verus-via/AI-designed-spectrophotometer-build/git hub fidelity 1/Fidelity1/images/README.md

# Images

| File | What it is |
|---|---|
| `photo_assembled.jpg` | Photo of the finished instrument with a cuvette; cap lifted off |
| `photo_parts.jpg` | Photo of the printed parts and electronics before assembly |
| `exploded_view.png` | Annotated exploded view of the full assembly |
| `assembly_render.png` | CAD render of the assembled instrument (cuvette shown translucent) |
| `printed_parts_sheet.png` | CAD render of each printed part in print orientation |

The two renders were generated from `cad/vs_body.scad` with OpenSCAD.
