verus-via/AI-designed-spectrophotometer-build/git hub fidelity 1/Fidelity1/docs/bom.md

# Bill of materials

Prices vary by seller and are deliberately not listed.

| # | Part | Qty | Notes |
|---|---|---|---|
| 1 | ESP32-C6 SuperMini board | 1 | Board outline modelled as 25.6 × 18.0 × 1.0 mm; **measure yours**, clones differ |
| 2 | Adafruit TSL2591 breakout (original, 0.75" × 0.65") | 1 | 19.05 × 16.51 × 1.6 mm; detector plate pegs fit its two Ø2.5 mounting holes |
| 3 | WS2812B LED on a round board, ~10 mm × 3 mm | 1 | BTF-LIGHTING round WS2812B board (Amazon ASIN B01DC0J3UM) was used |
| 4 | Plano-convex half-ball lens, Ø5 mm, borosilicate (n ≈ 1.474) | 2 | Vendor-stated focal length 5 mm; flat face toward the LED / detector, convex side toward the cuvette |
| 5 | Standard macro cuvette, 12.5 × 12.5 × 45 mm, 10 mm path | 1 | Glass or polystyrene (visible only) |
| 6 | ~330 Ω resistor | 1 | In series with the LED data line |
| 7 | M2 self-tapping screws | 8 + 2 | 4 per end plate (counterbored), plus 2 up through the deck into the body |
| 8 | M3 screws | 3 | Hold the puck deck to the cup bosses (countersunk) |
| 9 | Hookup wire, 28–30 AWG | few | Silicone-insulated suits the wire channels; fits the plate grooves |
| 10 | USB-C cable | 1 | Power and serial data |
| 11 | 3D-printed parts | — | See [assembly.md](assembly.md) |

Screw lengths are not fixed by the CAD; choose lengths that bite 5–6 mm into the M2 pilots
(pilot depth 6 mm) without breaking through, and check M3 length against the 3 mm deck plus
the boss depth.
