verus-via/AI-designed-spectrophotometer-build/git hub fidelity 1/Fidelity1/stl/vs_cap.stl

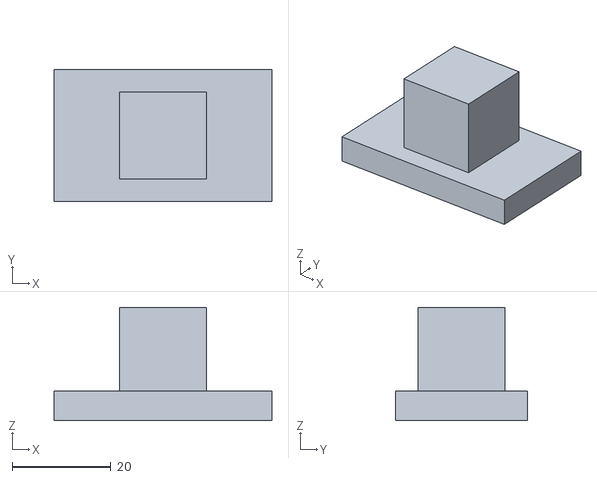
[picture p7: CAD file, 2026-10-20]
git hub fidelity 1/Fidelity1/stl/vs_cap.stl
44.2 x 26.7 x 23.0
