verus-via/AI-designed-spectrophotometer-build/git hub fidelity 1/Fidelity1/stl/vs_body.stl

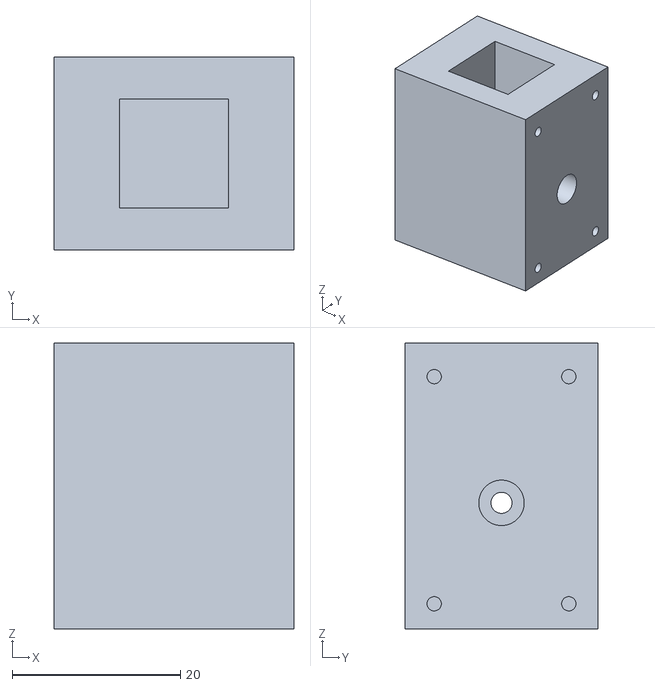
[picture p8: CAD file, 2026-10-20]
git hub fidelity 1/Fidelity1/stl/vs_body.stl
28.5 x 23.0 x 34.0
