verus-via/AI-designed-spectrophotometer-build/git hub fidelity 1/Fidelity1/stl/vs_det_plate.stl

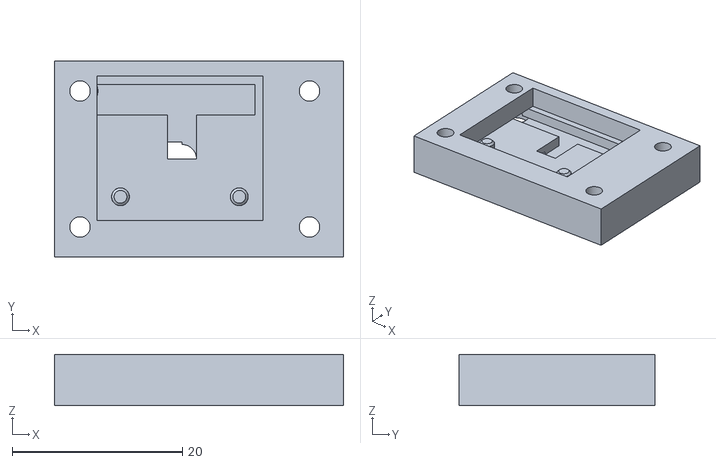
[picture p9: CAD file, 2026-10-20]
git hub fidelity 1/Fidelity1/stl/vs_det_plate.stl
34.0 x 23.0 x 6.00
