verus-via/AI-designed-spectrophotometer-build/git hub fidelity 1/Fidelity1/stl/vs_base_cup.stl

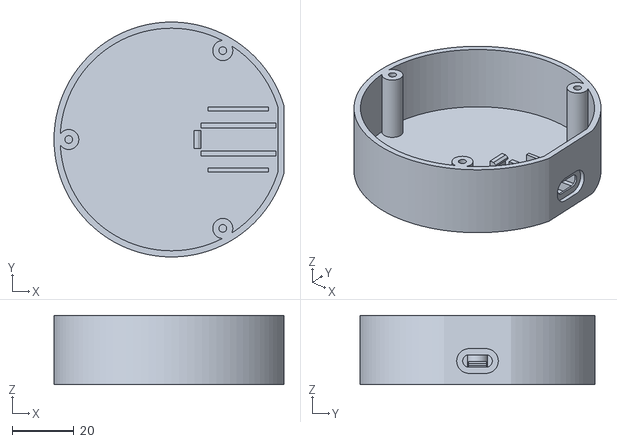
[picture p10: CAD file, 2026-10-20]
git hub fidelity 1/Fidelity1/stl/vs_base_cup.stl
74.6 x 76.2 x 22.4
