verus-via/AI-designed-spectrophotometer-build/git hub fidelity 1/Fidelity1/stl/vs_ring.stl

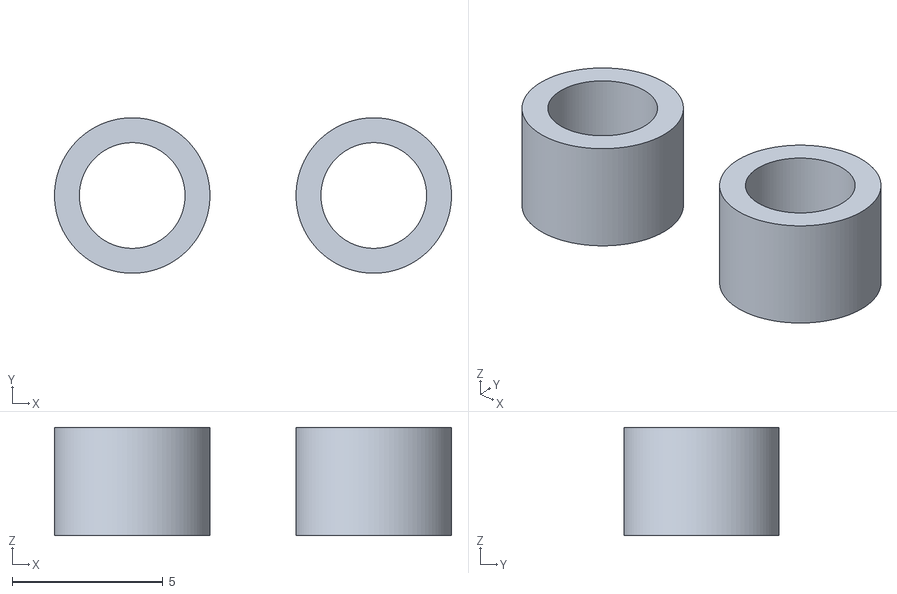
[picture p12: CAD file, 2026-10-20]
git hub fidelity 1/Fidelity1/stl/vs_ring.stl
13.1 x 5.15 x 3.58
